root47-alt/DisplayGlasses/tools/optics/calculator.html

# DisplayGlasses Optics

Try lenses and beam splitters before you buy them. Move the sliders to see how big the text looks, whether your eye can see the whole screen, and where the screen has to sit to be in focus.

Screen: 0.96 in SSD1306 OLED · 128 × 64 px · 0.17 mm pixels · 21.7 × 10.9 mm lit area · 4 mm pupil

## Parts

Lens focal length

Printed on the lens listing, often as "f".

Lens diameter

Beam splitter

Flat plate Cube

Plate shape

Round Rectangle

Plate diameter

Plate height

Eye to splitter center

From your pupil. A bigger splitter has to sit farther out so its near edge clears your eyelashes.

Text floats at

## What your eye sees

Glasses slip sideways 0 mm up/down 0 mm

One eye's view, with grid lines every 10°. The dashed box is the screen's edge. Only lit pixels show up; dimmed or missing pixels are blocked by the lens or the splitter. Slide the glasses to see which corners dim first.

## Layout from above, to scale

Light leaves the screen, passes the lens, bounces off the splitter into your eye. Dashed lines are the screen's left and right edges.

## Compare common setups

Setup | Image | Text at 1 m | Eye box | Screen → splitter | Weight

Eye box is how far the glasses can slide sideways (or up and down) on your face before any part of the screen starts to dim, corners included. Half bright is how far they can slide before an edge or corner drops to about half brightness. Under 3 mm feels fussy; 5 mm or more is comfortable.

Plate shape: the splitter tilts 45°, so from your eye it looks narrower than it is, while the image is wide. Put a rectangular plate's long side horizontal. The image's corners pass through the plate's corners, so a square or rectangular plate keeps them brighter than a round one.

Near edge: the tilted splitter's nearest edge comes toward your eye. Keep it at least 16 mm from your pupil so it clears your eyelashes. A bigger splitter has to sit farther out, so past about 40 mm wide it stops helping.

Focus range is how far the screen can move and still look sharp, from text floating at 0.5 m to text at infinity. The glasses module needs a slot about that long to fine-tune focus.

The model uses thin-lens optics and traces rays from your pupil to the screen's edges and corners through the splitter and the lens. Real lenses blur a little toward the edges, so treat the numbers as a guide and confirm them on the optics bench.
