root47-alt/DisplayGlasses/docs/images/screens/demo.gif

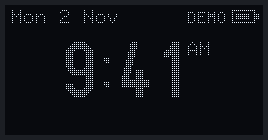
docs/images/screens/demo.gif
