root47-alt/DisplayGlasses/cad/stl/cube_holder_25.4mm.stl

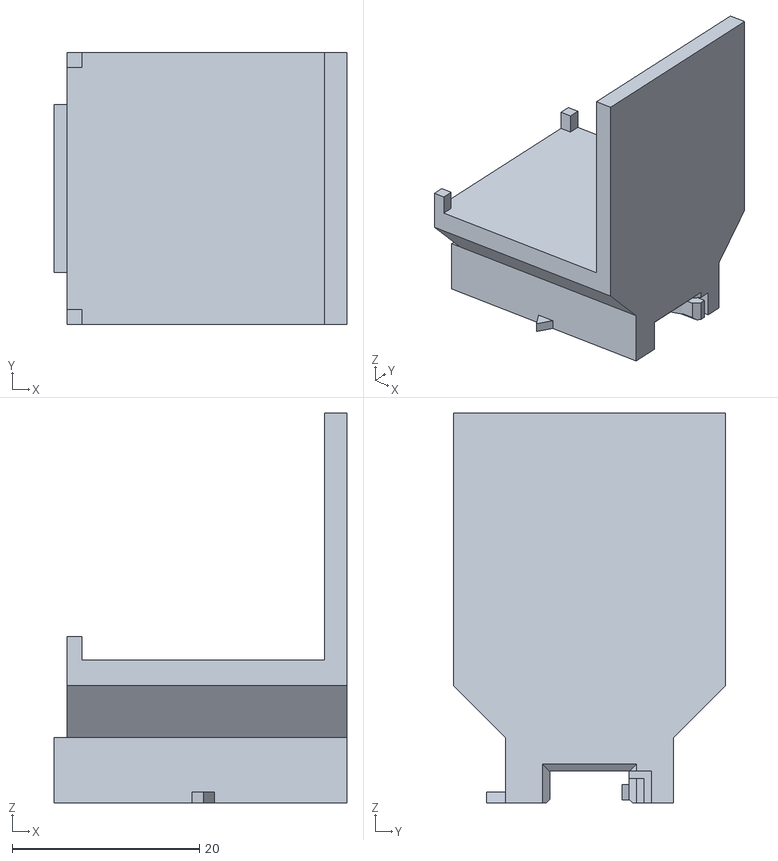
[picture p7: CAD file, 2026-11-04]
cad/stl/cube_holder_25.4mm.stl
31.3 x 29.1 x 41.7
