root47-alt/DisplayGlasses/cad/stl/glasses/frame.stl

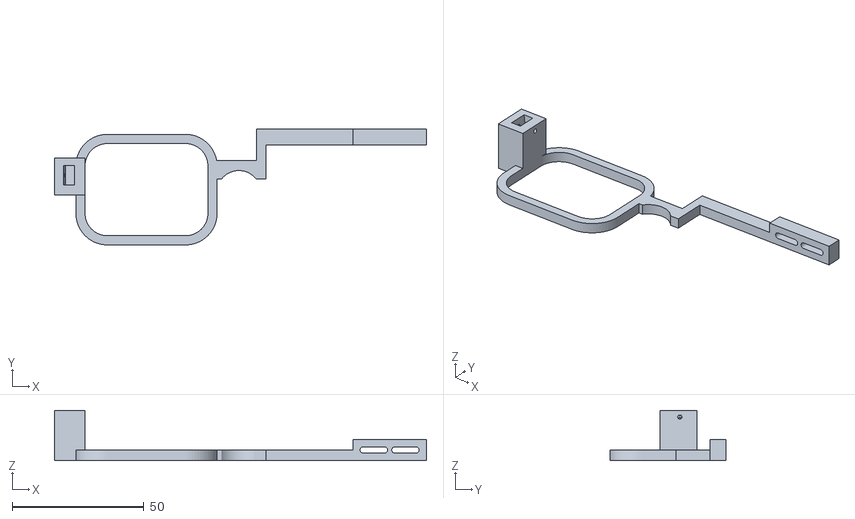
[picture p8: CAD file, 2026-11-04]
cad/stl/glasses/frame.stl
141.2 x 44.0 x 19.0
