root47-alt/DisplayGlasses/cad/stl/cube_holder_15mm.stl

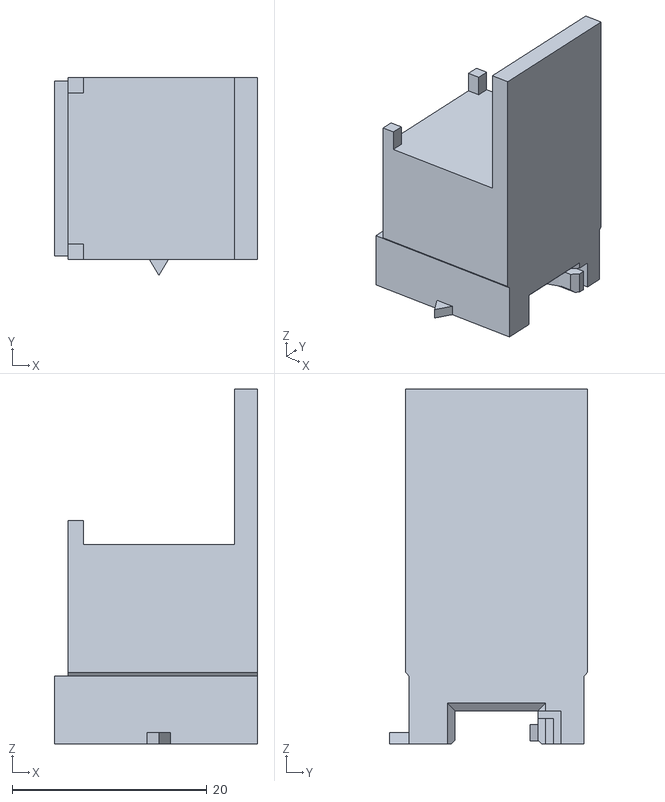
[picture p9: CAD file, 2026-11-04]
cad/stl/cube_holder_15mm.stl
20.9 x 20.3 x 36.5
