root47-alt/DisplayGlasses/cad/stl/glasses/module_upper.stl

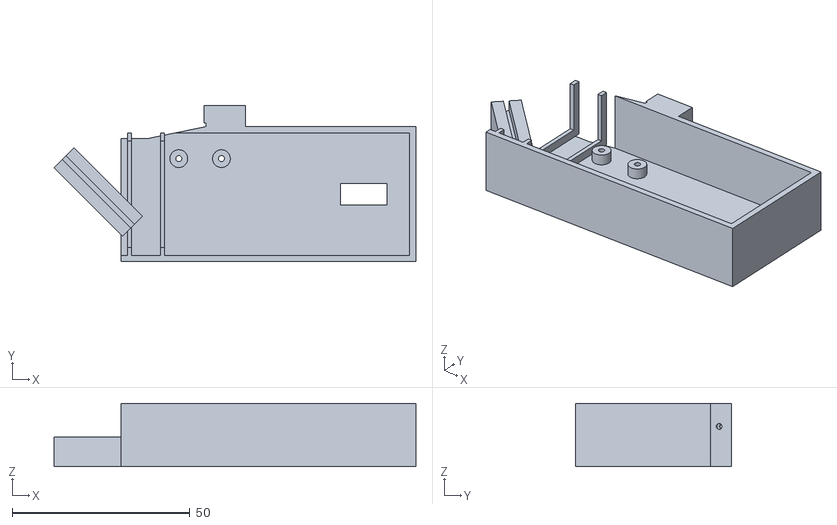
[picture p10: CAD file, 2026-11-04]
cad/stl/glasses/module_upper.stl
101.8 x 44.0 x 17.8
