root47-alt/DisplayGlasses/cad/stl/cube_holder_20mm.stl

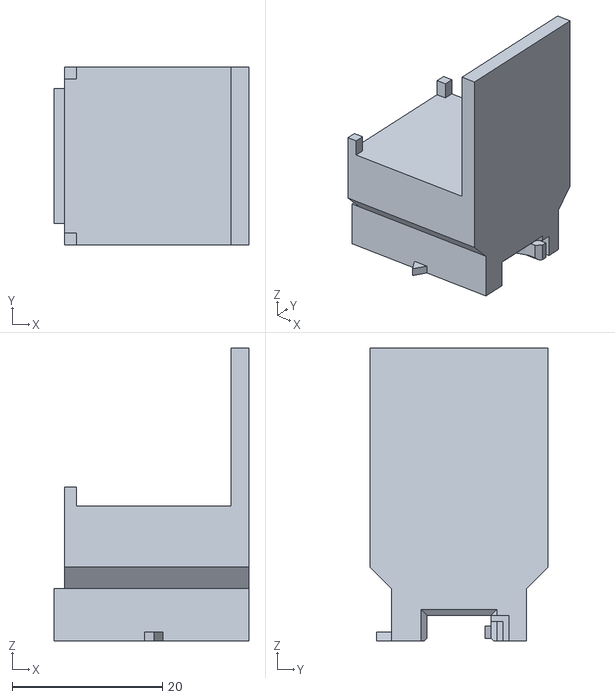
[picture p11: CAD file, 2026-11-04]
cad/stl/cube_holder_20mm.stl
25.9 x 23.7 x 39.0
