root47-alt/DisplayGlasses/cad/stl/glasses/temple.stl

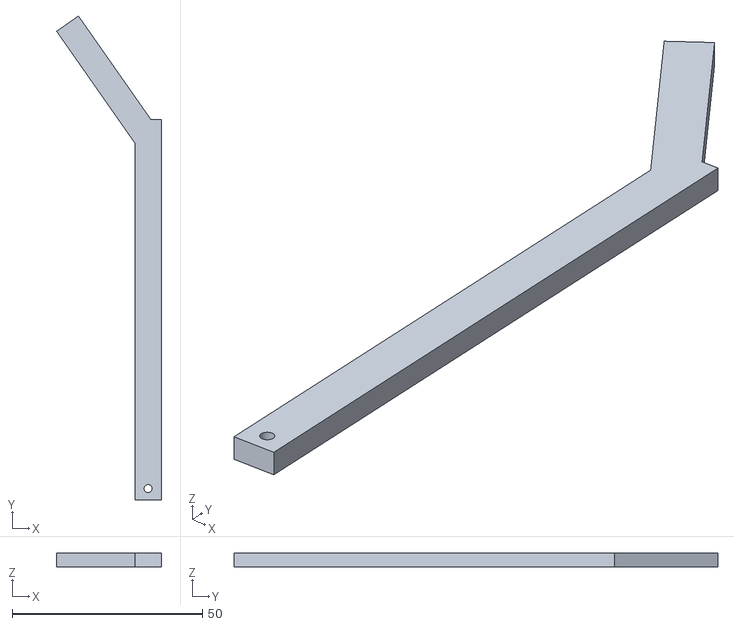
[picture p12: CAD file, 2026-11-03]
cad/stl/glasses/temple.stl
27.5 x 127.1 x 3.60
