root47-alt/DisplayGlasses/cad/stl/glasses/pod_lid.stl

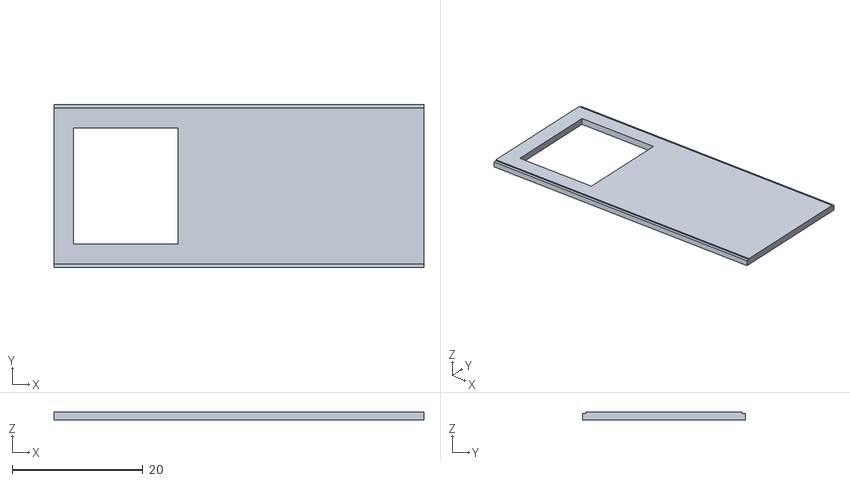
[picture p13: CAD file, 2026-11-02]
cad/stl/glasses/pod_lid.stl
56.6 x 24.9 x 1.20
