root47-alt/DisplayGlasses/cad/stl/lens_holder_25mm.stl

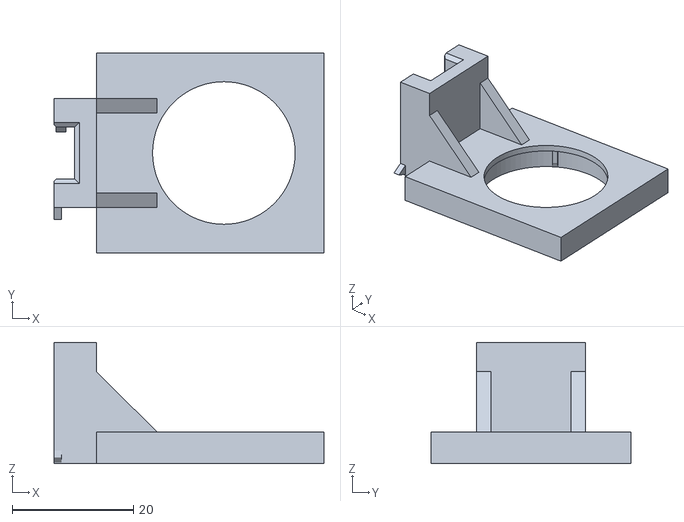
[picture p14: CAD file, 2026-11-04]
cad/stl/lens_holder_25mm.stl
44.5 x 33.0 x 20.0
