root47-alt/DisplayGlasses/cad/stl/glasses/screen_sled.stl

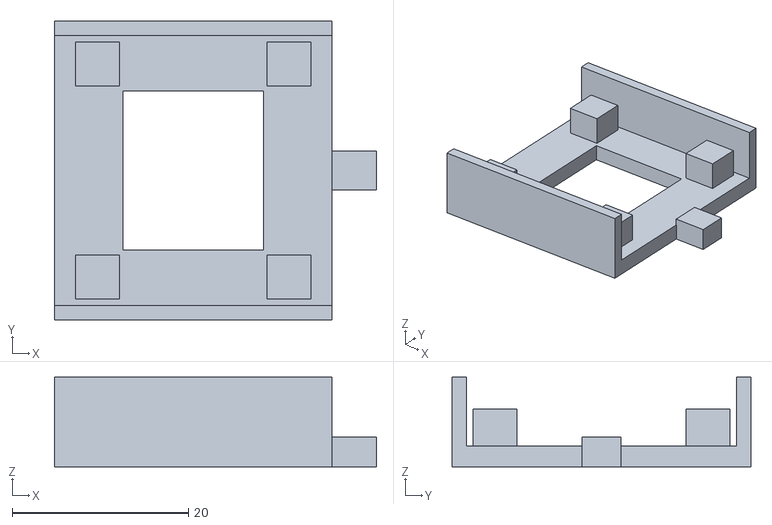
[picture p15: CAD file, 2026-11-02]
cad/stl/glasses/screen_sled.stl
36.5 x 33.9 x 10.2
