root47-alt/DisplayGlasses/cad/stl/lens_holder_34mm.stl

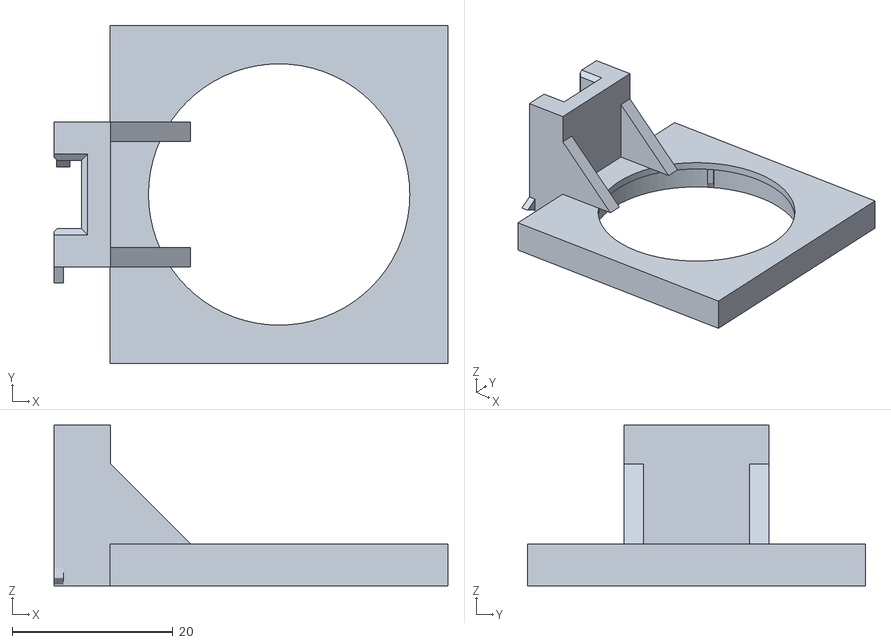
[picture p16: CAD file, 2026-11-04]
cad/stl/lens_holder_34mm.stl
49.0 x 42.0 x 20.0
