root47-alt/DisplayGlasses/cad/stl/glasses/lens_ring.stl

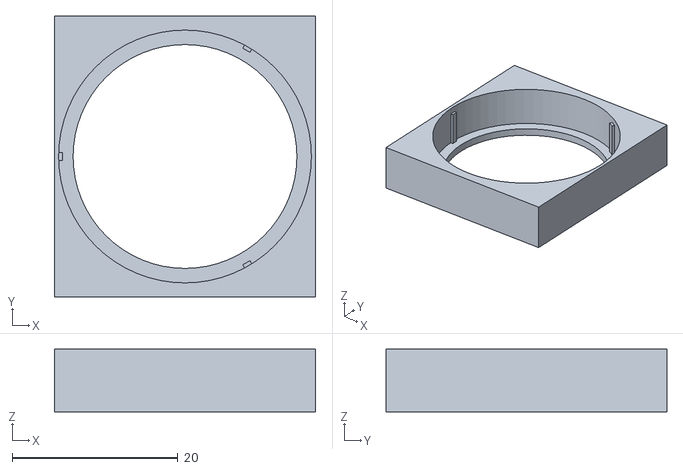
[picture p17: CAD file, 2026-11-02]
cad/stl/glasses/lens_ring.stl
31.5 x 33.9 x 7.60
