root47-alt/DisplayGlasses/cad/stl/plate_holder_thick.stl

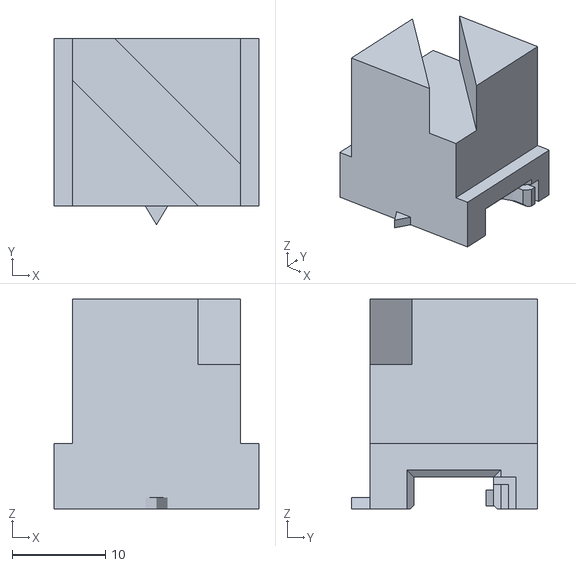
[picture p18: CAD file, 2026-11-04]
cad/stl/plate_holder_thick.stl
22.0 x 20.0 x 22.5
