root47-alt/DisplayGlasses/cad/stl/glasses/pod_body.stl

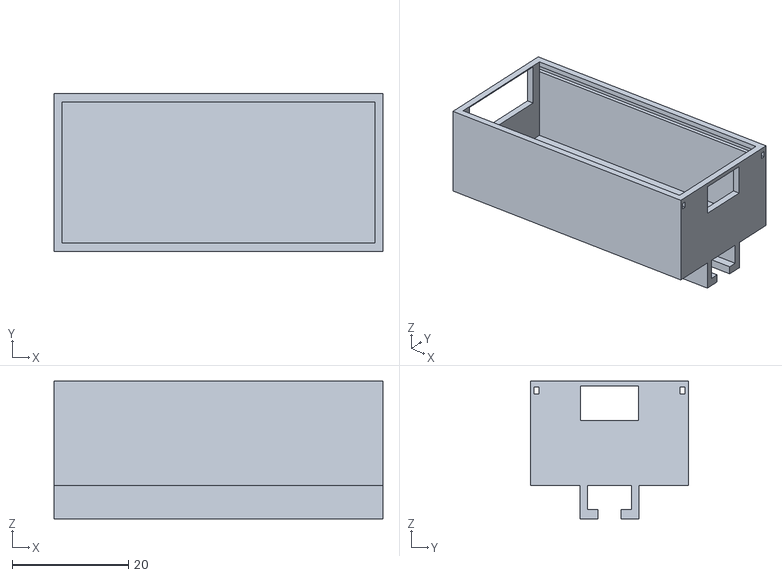
[picture p19: CAD file, 2026-11-02]
cad/stl/glasses/pod_body.stl
56.6 x 27.1 x 23.7
