root47-alt/DisplayGlasses/cad/stl/oled_holder.stl

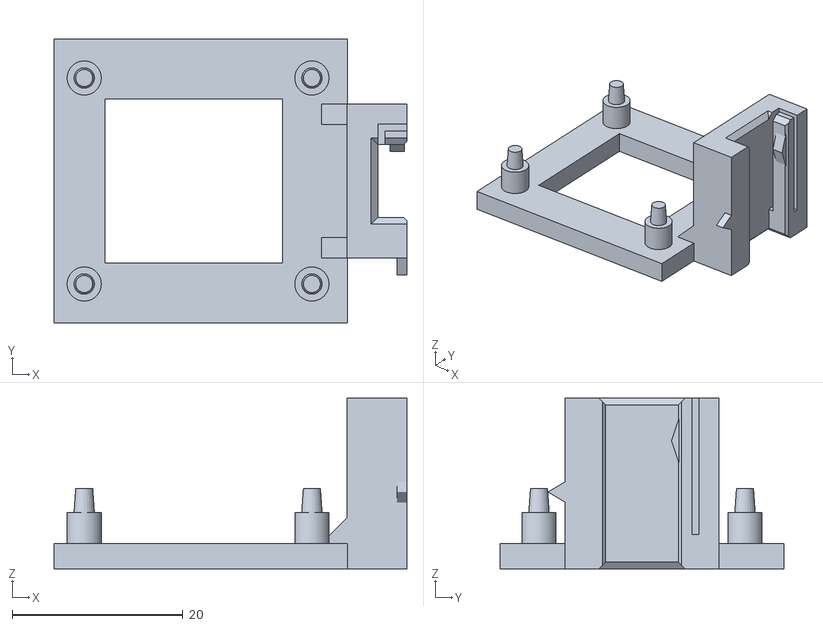
[picture p20: CAD file, 2026-11-04]
cad/stl/oled_holder.stl
41.3 x 33.2 x 20.0
