root47-alt/DisplayGlasses/cad/stl/glasses/module_lower.stl

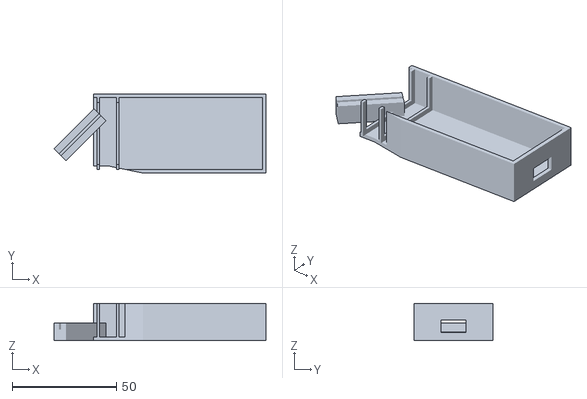
[picture p21: CAD file, 2026-11-02]
cad/stl/glasses/module_lower.stl
101.8 x 38.0 x 17.8
