root47-alt/DisplayGlasses/cad/stl/lens_holder_30mm.stl

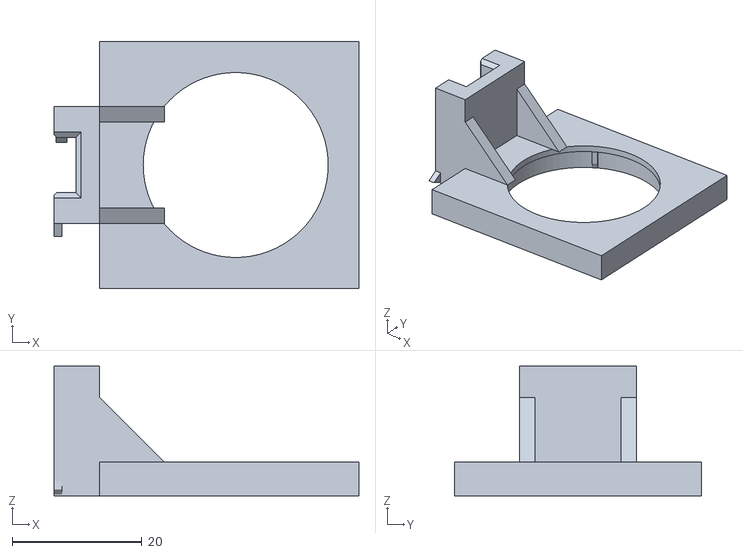
[picture p22: CAD file, 2026-11-04]
cad/stl/lens_holder_30mm.stl
47.0 x 38.0 x 20.0
