root47-alt/DisplayGlasses/cad/stl/fit_test.stl

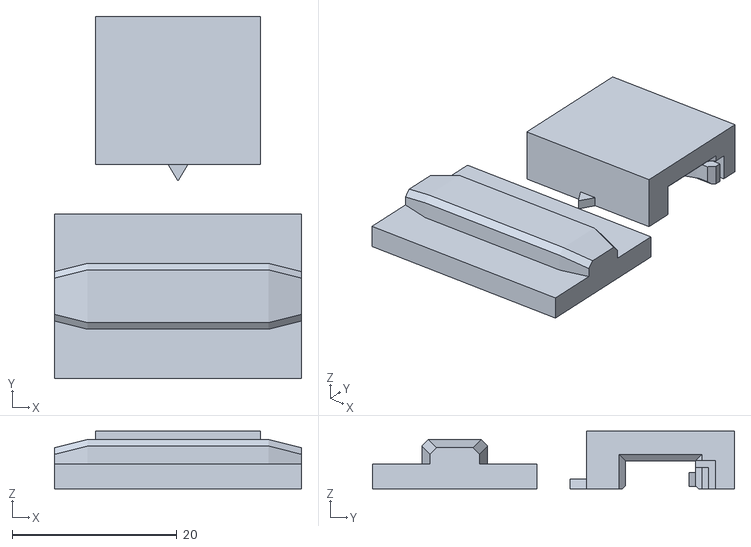
[picture p23: CAD file, 2026-11-04]
cad/stl/fit_test.stl
30.0 x 44.0 x 7.00
