root47-alt/DisplayGlasses/cad/stl/lens_holder_20mm.stl

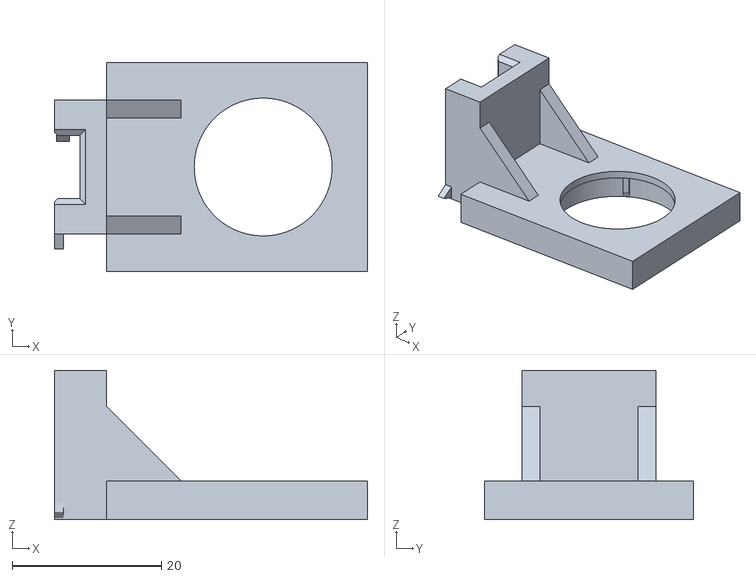
[picture p24: CAD file, 2026-11-04]
cad/stl/lens_holder_20mm.stl
42.0 x 28.0 x 20.0
