root47-alt/DisplayGlasses/cad/stl/plate_holder.stl

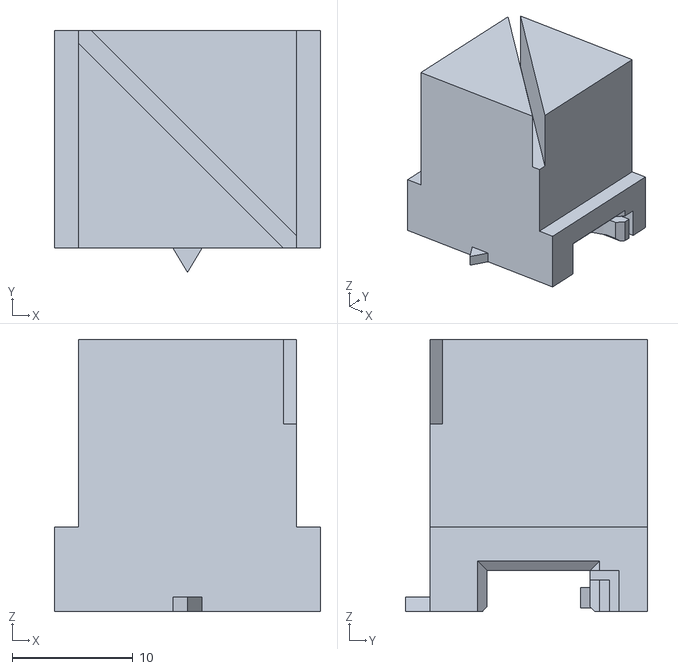
[picture p25: CAD file, 2026-11-04]
cad/stl/plate_holder.stl
22.0 x 20.0 x 22.5
