root47-alt/DisplayGlasses/cad/stl/lens_holder_25.4mm.stl

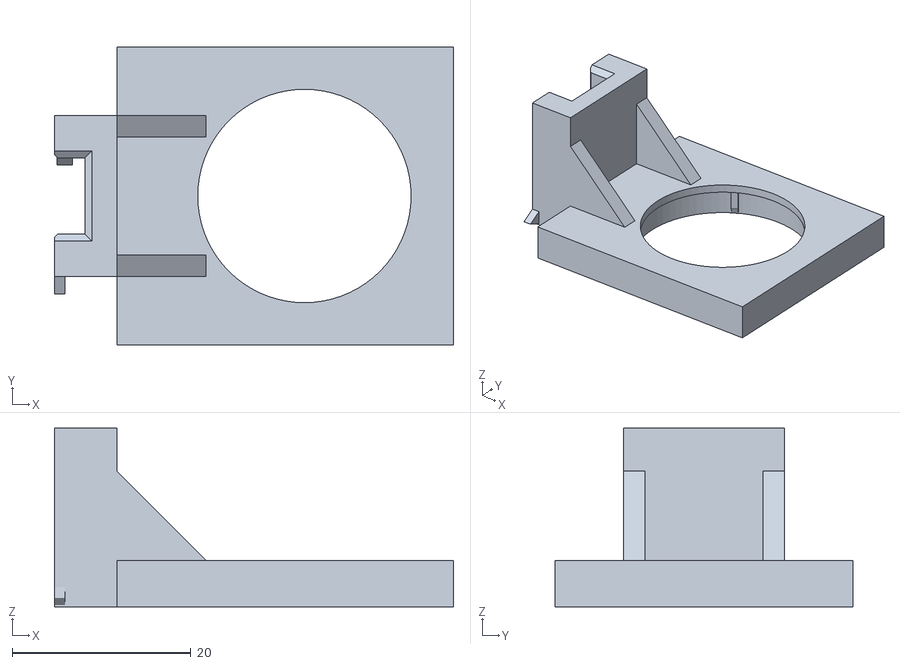
[picture p26: CAD file, 2026-11-04]
cad/stl/lens_holder_25.4mm.stl
44.7 x 33.4 x 20.0
