root47-alt/DisplayGlasses/cad/stl/rail.stl

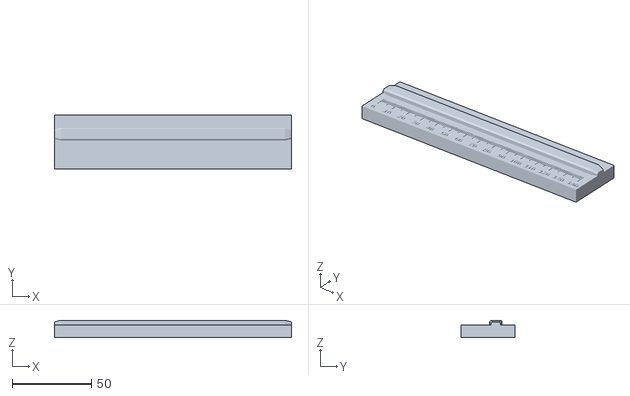
[picture p27: CAD file, 2026-11-02]
cad/stl/rail.stl
150.0 x 34.0 x 11.0
