root47-alt/DisplayGlasses/firmware/src/iphone_link.h

#pragma once
// Bluetooth link to an iPhone. The glasses pair like a smartwatch and use two
// services built into iOS, so no iPhone app is needed:
//   - ANCS (Apple Notification Center Service): every notification on the phone
//   - CTS (Current Time Service): the phone's clock
//
// The slow Bluetooth work (finding services, asking for notification text)
// runs on its own FreeRTOS task, so the screen and button never wait on it.
// The handlers below are called from loop(), on the Arduino task.

#include <cstdint>
#include <functional>
#include <string>

#include "clock.h"

namespace iphone {

struct Handlers {
  // A new notification arrived (raw text, not yet cleaned up). `uid` is the
  // iPhone's id for it, which onRemoved uses later.
  std::function<void(uint32_t uid, const std::string& appId, uint8_t category, const std::string& title,
                     const std::string& subtitle, const std::string& message)>
      onNotification;
  // A notification went away on the phone: read, cleared, or a call ended.
  std::function<void(uint32_t uid)> onRemoved;
  // The phone told us its local time.
  std::function<void(const clockutil::DateTime& localTime)> onTime;
  // connected: a phone is connected. ready: paired and sharing notifications.
  std::function<void(bool connected, bool ready)> onLinkChange;
};

// Starts Bluetooth and advertises as `name` until an iPhone connects.
void begin(const char* name, const Handlers& handlers);

// Call every loop(). Delivers what the Bluetooth task received to the
// handlers. Never blocks.
void loop();

// Forgets the paired iPhone. Restart afterwards, then "Forget This Device" on
// the iPhone and pair again.
void forget();

}  // namespace iphone
