root47-alt/DisplayGlasses/(commit log)

2026-11-02 Add DisplayGlasses firmware, docs and build setup
    ESP32-S3 firmware for a one-eye HUD that pairs with an iPhone like a
    smartwatch: notifications over ANCS, time over CTS, weather and Claude
    answers via iOS Shortcuts notifications. Includes a demo mode, Wokwi
    simulator config, unit tests for the core logic, and docs for parts,
    iPhone setup and optics.
    Claude-Session: https://claude.ai/code/session_01SGKWMgsBJah17zpCS1tQze
    [button.h, config.h, demo.cpp, demo.h, hud.cpp, hud.h, iphone_link.cpp, iphone_link.h]
2026-11-02 Add 3D-printable optics bench for finding the display optics distances
    A rail with an engraved millimeter scale plus sliding holders for the
    OLED, a lens (20/25/30/34 mm) and a beam splitter cube or glass plate.
    Holders grip the rail with a printed spring finger, and each pointer
    marks its optical plane, so distances read straight off the scale.
    Parametric OpenSCAD source, ready-to-print STLs (no supports), a fit
    test piece, preview renders, and updated print and optics docs.
    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
    [cube_holder_15mm.stl, fit_test.stl, lens_holder_20mm.stl, lens_holder_25mm.stl, lens_holder_30mm.stl, lens_holder_34mm.stl, oled_holder.stl, optics_bench.scad]
2026-11-02 Add optics calculator for choosing the lens and beam splitter
    Thin-lens model plus ray tracing through the lens and splitter edges:
    focus distance and range, image size, text size, eye box and how much
    of the screen is visible. Python CLI and a web page with identical
    math (checked against each other), a simulated view through the
    glasses and a to-scale top view. Docs summarize the result: a ~50 mm
    focal-length lens with a thin plate splitter beats the 15 mm cube.
    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
2026-11-02 Update parts list with checked links, stock and calculator-backed optics
    Real product links and prices checked today; the ESP32-S3 Feather is
    out of stock, so the ESP32 Feather V2 is listed as an in-stock option
    and the firmware gains feather_v2 / feather_v2_demo builds (both
    compile). Optics now follow the calculator: a 25 mm, 50 mm focal-length
    lens and a 1 mm AR-coated plate splitter instead of the 15 mm cube.
    Bench and optics docs updated for a plate splitter.
    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
2026-11-02 Fix review and simulator findings; add screen simulator, screen tests, CI and browser flasher
    Firmware fixes from an independent review and from the new simulator:
    - Calls (and notifications read on the phone) leave the screen when the
    iPhone removes them; a newer call replaces an older one.
    - Bluetooth setup and requests run on their own FreeRTOS task, so the
    screen and button never block on GATT calls.
    - Detect a quick disconnect+reconnect, re-run setup on Service Changed,
    keep the advertised name after a stack reset, drop the oldest pending
    notification consistently.
    - Startup text fits, "no phone" no longer blinks itself off, toasts take
    over the screen instead of overlapping t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
    [demo.cpp, demo.h, hud.cpp, hud.h]
2026-11-02 Recommend a 30 mm, 60 mm focal-length lens after accounting for eyelashes
    The tilted splitter's near edge sits ~9 mm closer than its center, so the
    center has to be ~25 mm from the pupil to clear eyelashes. At that
    distance a 25 mm / f50 lens leaves a 0.7 mm eye box; a 30 mm / f60 lens
    gives 4.5 mm with the same 25 mm plate. Calculator defaults, presets,
    optics guide and parts list updated; JS and Python still agree.
    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
2026-11-02 Add draft glasses design: printed frame, display module and battery pod
    glasses.scad (parametric, origin at the right pupil): frame front with a
    brow bar that bolts onto the display module through adjustment slots;
    temples on tongue-and-pin sockets; a two-half display module holding the
    lens ring, a 45-degree plate splitter and a focus sled; and a battery pod
    for the Feather + 400 mAh LiPo that slides onto the right temple. Sized
    from the optics calculator. STLs (all closed solids, oriented for
    printing without supports), renders and assembly docs included.
    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
    [frame.stl, glasses.scad, lens_ring.stl, module_lower.stl, module_upper.stl, pod_body.stl, pod_lid.stl, screen_sled.stl]
2026-11-03 Trace the optics calculator in 2D so it checks the screen's corners
    The calculator checked horizontal and vertical rays separately, so it
    never looked at the screen's corners. Those rays pass through the
    plate's corners, which a round plate doesn't have, and through the
    edge of the round lens. A 25 mm round plate's eye box was overstated:
    the old model said 4.5 x 16.5 mm. It is really 4.3 x 4.2 mm with no
    dimming, or 8.3 x 13.8 mm before an edge drops to half brightness.
    - optics.py, optics.js
    - Trace rays in 2D over a 5x3 screen grid, corners included, with a
    sampled pupil.
    - Model round or rectangular plates.
    - Add a half-bright eye box.
    - Report the plate's near-edge distance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
2026-11-03 Parts list: add the M2 screws, drop the store-bought glasses
    The frame is printed now, so a pair of glasses is no longer needed. The
    screws the glasses need were only mentioned in the CAD notes; they're on
    the list now, with a screwdriver and epoxy for closing the module (super
    glue fumes can fog the optics). The lens row names the Edmund part and
    its real price, and the total is broken down by group.
    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
2026-11-03 Turn the glasses off with the button
    Hold the button until the screen says "Turn off" (2 s) and let go: the
    glasses go into deep sleep, with the screen's power cut, and a press
    turns them back on (the chip starts up from the beginning). The battery
    still charges over USB while they're off.
    The button's actions are now picked by how long it's held, and the
    screen says what letting go will do:
    - Let go before 2 s: dismiss / show the last notification (as before;
    a slow press no longer flips the image by accident)
    - 2-5 s: turn off
    - 5-8 s: flip the image (was 1-8 s)
    - 8 s: forget the iPhone (as before)
    A press that's still held when the glasses wake up is ignored, so
    holding the button to t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
    [button.h, config.h, hud.cpp, hud.h, main.cpp, power.cpp, power.h]
2026-11-03 Show the battery level, warn when low, turn off when empty
    The home screen's top-right corner now shows a battery icon, plus the
    percentage while the iPhone is connected (the phone's status takes that
    spot otherwise). The corner uses a smaller font so it stays clear of the
    longest date, and "pairing..." became "pairing" to fit.
    - At 10%, a "Battery low" message pops up once (again after charging).
    - When the battery stays under 3.4 V for a minute, the glasses say
    "Battery empty" and turn off instead of running the cell flat.
    - Feather V2: voltage through the divider on BATT_MONITOR (A13), mapped
    to a percentage with a LiPo discharge curve. ESP32-S3 Feather: the
    MAX17048 fuel gauge's o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
2026-11-03 Bench: holders for 1-inch lenses, 20 mm and 1-inch cubes, thick plates
    School optics labs usually have 1-inch (25.4 mm) lenses and cubes, and
    plate splitters thicker than the 1.2 mm slot. These are small prints,
    so they can go in the same batch as the rest of the bench, before it's
    known which optics the lab lends.
    - lens_holder_25.4mm.stl: the 25 mm holder's crush ribs would squeeze a
    1-inch lens by 0.8 mm, too much for PLA.
    - cube_holder_20mm.stl, cube_holder_25.4mm.stl
    - plate_holder_thick.stl: slot for plates up to 6 mm.
    All exported from optics_bench.scad as binary STL, watertight, flat on
    the bed.
    Claude-Session: https://clau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
    [cube_holder_20mm.stl, cube_holder_25.4mm.stl, lens_holder_25.4mm.stl, plate_holder_thick.stl]
2026-11-03 Glasses: size the frame and arms to real measurements, fix the hinge
    Sized for pupil distance 58.5 mm, a 140 mm frame, arms 100 mm from hinge
    to bend, a 16.5 mm bridge and a 150 mm head, so the frame and temples can
    be printed now to check the fit.
    Fixes:
    - The temple's pin hole sat 4.5 mm from the tongue's tip but the sockets'
    holes are 3 mm from the slot's end, so the pin couldn't go through.
    The hole is now 3 mm from the tip.
    - The right temple ran 41 mm from the right pupil, about 8 mm farther out
    than the left one, which would push the frame off center. Its socket
    now mirrors the left one.
    - The left socket ended 9 mm in front of the right one, so the two bends
    landed at diff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
    [frame.stl, glasses.scad, module_upper.stl, temple.stl]
2026-11-04 Bench: a smaller fit test that prints in about half the time
    The fit test only has to check how a holder slides on the ridge, so the
    rail piece is now 30 mm long, 20 mm wide and 3 mm thick under the ridge
    (was a full 40 mm rail). Sliced estimate: about 7.5 min on a fast
    printer and 23 min on a slower one (was 13 and 43); 3.8 g of PLA.
    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
    [fit_test.stl, optics_bench.scad]
2026-11-04 Glasses: keep the frame in one piece, line the brow bar screws up
    The brow bar's two adjusting slots overlapped, so together they cut its
    block in two: frame.stl had a loose strip (since the first version).
    They also ran 2 mm behind the module's screw holes, so the screws would
    have missed them.
    - Screws 12 mm apart (was 8), each slot adjusts 4 mm either way (was 5),
    with plastic left between them; the block is 4 mm longer.
    - Slots, pilot holes and bosses all on one line, y_joint.
    frame.stl and module_upper.stl re-exported; every glasses part is now a
    single piece.
    Claude-Session: https://claude.ai/code/session_01SGKWMgsBJah17zpCS1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
    [frame.stl, glasses.scad, module_upper.stl]
2026-11-04 Glasses: seat the left temple socket on the rim, open the slots cleanly
    Found while checking the print files with an overhang scan and a slicer
    run:
    - The left temple socket hung 2.9 mm past the end piece over the rim's
    opening, an unsupported ledge in the print. The rim's outer edge now
    sits under the socket (the rim is 3 mm narrower).
    - Turning the temple slots for the splay left a 0.2 mm sliver across
    the slot mouth. The slot cut now runs 2 mm past the socket's back.
    frame.stl and module_upper.stl re-exported, one piece each; the slicer
    no longer reports floating bridge anchors on the frame.
    Claude-Session: https://claude.ai/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
    [frame.stl, glasses.scad, module_upper.stl]
2026-11-04 Bench: fit the real screen board, reach the glasses' lens gap, fix the grip
    From an independent review of the print files, each finding checked
    against Adafruit's board file, OpenSCAD intersection tests with models
    of the real parts, and slicing:
    - Screen holder: the Adafruit #326 STEMMA QT board is 29.21 x 31.75 mm
    with two mounting ears at the bottom (the holder assumed a plain
    29.2 x 26.7 rectangle), so its corner brackets blocked the ears. The
    board now hangs on four tapered pins through its mounting holes, with
    posts clear of the parts on its back, and its lit area (19.4 mm up
    from the ears) on the optical axis. Real board model: no overlap.
    - Lens holder: the bases butted 28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
    [cube_holder_15mm.stl, cube_holder_20mm.stl, cube_holder_25.4mm.stl, fit_test.stl, frame.stl, glasses.scad, lens_holder_20mm.stl, lens_holder_25.4mm.stl]
2026-11-04 Bench: cube holders print without support
    The cube holder's table and back wall are wider than the base, so they
    hung out 3-5.5 mm over thin air from the base's top (5.5 mm for the
    1-inch cube). They now widen from the base at 45 degrees. A 25.4 mm cube
    still sits on the table between the corner posts with no overlap, and
    PrusaSlicer reports no floating anchors. The 1-inch holder is tall for
    its footprint, so it gets a brim like the lens holders.
    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
    [cube_holder_15mm.stl, cube_holder_20mm.stl, cube_holder_25.4mm.stl, optics_bench.scad]
